Florian221-art/smart_garden/(commit log)

2026-09-28 docs: Projektplan, API-Vertrag und Aufgabenteilung ESP/Webserver
    Claude-Session: https://claude.ai/code/session_01HQDixhkMMb3qe8uDzTaNaT
2026-09-28 docs: Pinout/Verkabelungsplan, Grove-Relais fuer Pumpe, Claude-Regeln in .claude/
    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
2026-09-28 docs: Pinout-Diagramm an echte Board-Belegung angepasst
    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
2026-09-28 docs: KI zu Claude-Web, Pi-Hotspot, Arduino IDE, Tank-Schaetzung (Vertrag v1.1)
    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
2026-09-28 docs: Tech-Stack festgelegt (C++/Arduino, Python/FastAPI, React+Tailwind, lokale KI)
    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
2026-09-28 docs: Demo-Modus (Sensorwerte ueberschreiben), LED-Bar Gruen-Rot, alle Sensordaten im Dashboard (Vertrag v1.2)
    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
2026-09-28 docs: Plaene um Demo-Modus, LED-Bar Gruen-Rot und vollstaendige Sensoranzeige ergaenzt
    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
2026-09-28 tools: fake_esp.py – ESP32-Simulator nach API-Vertrag v1.2
    Simuliert Bodenfeuchte, Licht, Temperatur, Luftfeuchte, Tank-Schaetzung,
    Auto-Bewaesserung mit Sicherheitsgrenzen und wertet commands/config/demo
    aus. Nur Python-Standardbibliothek.
    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
2026-09-28 firmware: ESP32-Firmware v0.1.0 + Verkabelung v2 (kapazitiver Bodensensor)
    - Sensoren: kapazitive Bodenfeuchte (GPIO34), LDR (GPIO35), DHT11 (GPIO4)
    - LED-Bar Rot->Gruen fuer Bodenfeuchte, Summer, Status-LED
    - Auto-Bewaesserung mit harten Sicherheitsgrenzen, Tank-Schaetzung in NVS
    - Demo-Modus (Server + serielle Konsole), Kalibrierung per Konsole
    - POST nach API-Vertrag v1.2, uebernimmt config/commands/demo
    - Kompiliert mit ESP32-Core 3.3.12 ohne Warnungen
    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
2026-09-28 docs: Firmware-Anleitung, Verkabelung v2 (kapazitiver Sensor), Status Claude-ESP
    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
2026-09-28 Phase 1: WLAN-Hotspot-Setup, FastAPI-Grundgerüst, React-Dashboard
    - deploy/: setup_hotspot.sh (NetworkManager-Hotspot "SmartGarden" auf
    wlan0, Pi-IP 10.42.0.1), systemd-Unit, README mit Deployment-Schritten
    - server/: FastAPI + SQLAlchemy/SQLite. POST /api/v1/readings exakt nach
    api-contract.md v1.2 (Pydantic-Validierung, API-Key-Prüfung via argon2,
    Rate-Limit 1req/2s, Antwort mit commands/config/demo). Zusätzlich
    GET /api/v1/devices/{id}/latest fürs Dashboard, GET /healthz und
    CLI zum Anlegen von Geräten samt API-Key.
    - web/: React + Vite + TypeScript + Tailwind v4. Dashboard-Komponente
    pollt /latest alle 5s und zeigt alle aktuellen Sensordaten.
    - Lokal end-to-end getestet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
2026-09-28 docs: Fortschrittsdoku Claude-Web + Fehlertexte im Dashboard
    - docs/server/status.md: ausführliche Doku zu Hotspot/Backend/Dashboard, Testergebnissen und was sich durch den ESP-Firmware-Merge (PR #3, #5) geändert hat (Bodensensor, LED-Bar-Richtung, konkrete Fehlercodes)
    - web/src/errorMessages.ts: übersetzt die in smart_garden.ino definierten Fehlercodes (soil_out_of_range, light_read_failed, dht_read_failed, tank_empty) in verständlichen deutschen Text; unbekannte Codes werden unverändert angezeigt statt zu verschwinden
    - Dashboard zeigt jetzt den übersetzten Text, Rohcode(s) als Hinweis
2026-09-28 Dashboard: Verlaufsdiagramme + Verlaufs-API
    - server: GET /api/v1/devices/{id}/readings (Mittelwerte je Zeit-Bucket,
    Wasser-ml, Auto-Bewässerungen, Demo-Flag, Fehler) und
    GET /api/v1/devices/{id}/config; Zeitstempel jetzt mit Z (UTC)
    - server: app.dev_seed spielt simulierten Verlauf für die Entwicklung ein
    - web: Bereich "Verlauf" mit 1h/24h/7d, Kennzahlen und sechs Diagrammen
    (Bodenfeuchte mit Gießschwelle + Gieß-Markern, Tank, Wasser pro
    Zeitabschnitt, Temperatur, Luftfeuchte, Licht), Demo-Zeiträume markiert,
    Tabellenansicht, hell/dunkel mit geprüfter Palette
    - Status in plan-webserver.md und docs/server/status.md
    Cla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
2026-09-28 server: pydantic auf 2.13.5 für Python 3.14
    pydantic 2.9.2 (pydantic-core 2.23.4) hat keine fertigen Pakete für
    Python 3.14 und lässt sich dort nicht bauen (PyO3 0.22 unterstützt max.
    3.13) - pip install scheiterte auf dem Mac. 2.13.5 hat Wheels für macOS
    arm64 (Py3.14) und den Pi (aarch64, Py3.11/3.13); FastAPI 0.115 ist
    kompatibel. POST/401/422, /latest und /readings erneut getestet.
    Claude-Session: https://claude.ai/code/session_01PSo26csWhAiuDusFTWjDVb
2026-09-28 Fix: eigener LED-Bar-Treiber statt Grove-Library (#9)
    Die Library im Arduino-Bibliotheksverwalter ist eine aeltere Version ohne
    LED_BAR_10 -> Kompilierfehler. Eigener Treiber (ledbar.cpp), eine
    Bibliothek weniger zu installieren.
    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
    [display.cpp, ledbar.cpp, ledbar.h]
2026-09-28 server: SQLAlchemy auf 2.0.54 für Python 3.14
    SQLAlchemy 2.0.35 bricht unter Python 3.14 beim Import der Modelle ab
    (TypeError in make_union_type). Mit echtem Python 3.14 getestet:
    Seed, POST 200/401/422/429, /latest, /readings, /config, /openapi.json.
    Fertige Pakete für macOS arm64 (3.14) und Pi (aarch64, 3.11/3.13).
    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
2026-09-28 Demo-Modus (Server): Demo- und Befehls-Endpunkte
    - GET/PUT/DELETE /api/v1/devices/{id}/demo (Overrides + erzwungene Fehler,
    geprüft gegen Vertrag, 10-600 s, läuft serverseitig ab)
    - POST /readings liefert `demo` jetzt an den ESP (expires_in_s = Restzeit)
    - GET/POST /api/v1/devices/{id}/commands (gießen begrenzt auf
    max_pump_s_per_run, Tank aufgefüllt, identify, Summer; genau einmal)
    - Noch ohne Login: jeder im Hotspot kann die Demo auslösen (dokumentiert)
    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
2026-09-28 Demo-Modus (Dashboard): Szenario-Buttons, eigene Werte, Gerätebefehle
    - Demo-Steuerung mit 5 Szenarien, Schiebereglern, Sensorausfall,
    Dauer + Countdown, Bestätigung durch das Gerät, Gerätebefehle
    - DEMO-Banner für alle und DEMO-Badge an betroffenen Kacheln
    - Steuerung ein-/ausblendbar (Beamer-Ansicht)
    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
2026-09-28 Dashboard fürs Handy: WLAN-Zugriff, Web-App und Handy-Layout
    - web: `npm run dev:mobil` (vite --host) macht das Dashboard im WLAN
    erreichbar; /api läuft weiter über den Proxy auf dem Rechner
    - server: liefert web/dist unter / aus, falls gebaut - auf dem Pi reicht
    ein Dienst, Handy im Hotspot öffnet http://10.42.0.1:8000
    - Web-App-Manifest, eigenes Icon (Keimling mit Wassertropfen),
    theme-color, viewport-fit=cover -> "Zum Home-Bildschirm"
    - Handy-Layout: Kacheln und Szenarien zweispaltig, Touch-Ziele >= 44 px,
    safe-area für Notch/Home-Leiste, kein Fokusrahmen nach Antippen von
    Diagrammen, Demo-Zeitraum in der Legende statt abgeschnittenem Label
    - Geprüft per iPhone-13-Emulatio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
2026-09-28 Firmware v0.2.0 (#14)
    * firmware v0.2.0: Einstellungen ganz oben, LED-Zeiger, ruhigerer Summer, klare Pumpen-Sperrmeldung
    - Einstellungsblock (WLAN, Server, LED-Bar, Summer) in den ersten Zeilen von smart_garden.ino
    - LED-Bar: neuer Standard "Zeiger" (trocken = rot, feucht = gruen), Fuellbalken optional,
    CFG_LEDBAR_REVERSE zum Spiegeln, Testbefehl "ledseg"
    - Summer: piept nur bei neuem Problem, sonst max. alle 10 min; Grund als [ALARM] im Log; "mute"
    - Pumpe: Meldung, wenn Auto-Giessen wegen leerem Tank/Tageslimit gesperrt ist; Hinweis beim Start
    * docs: Firmwa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
    [display.cpp, display.h, garden_config.cpp, garden_config.h, smart_garden.ino]
2026-09-28 Firmware v0.2.1 (#15)
    * firmware v0.2.1: DHT11 stabil, kein Dauerpiepen, Demo giesst sofort
    - DHT11 nur alle 5 s lesen, letzten guten Wert 30 s halten (vorher: Lesen alle 2 s + erzwungener Retry -> Fehler)
    - Alarm: Sensorfehler erst nach 60 s, Problem gilt erst nach 5 min Ruhe als erledigt (kein Piepen bei Wackelkontakt)
    - "demo soil <x>" unter Grenzwert giesst sofort einmal, ohne die 5-min-Pause
    - Log-Meldung, wenn Giessen wegen Pause (Cooldown) wartet
    - LED-Test beim Start langsamer mit Hinweis
    * firmware v0.2.1: Demo-Kick, Alarm-Hysterese, LED-Test
    Co-Authore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
    [demo.cpp, demo.h, display.cpp, garden_config.h, pump.cpp, pump.h, sensors.cpp, smart_garden.ino]
2026-09-28 Firmware v0.2.2: LED-Bar Pins tauschbar (#16)
    * firmware v0.2.2: LED-Bar Daten-/Taktpin tauschbar (ledswap, CFG_LEDBAR_SWAP_PINS)
    * firmware v0.2.2: Einstellung + Konsolenbefehl ledswap
    ---------
    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
2026-09-28 Firmware v0.2.3: LED-Bar-Pins korrigiert (#17)
    Im Hardwaretest hat die LED-Bar erst nach "ledswap" reagiert. Pinbelegung
    jetzt fest so eingestellt, Verkabelungsplan angepasst (Kabel bleiben wie sie sind).
    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
    [garden_config.h]
2026-09-28 firmware v0.2.4: LED-Bar Trockenheitsbalken ab Grün (Standard)
    Je trockener die Erde, desto mehr LEDs: erst die grünen, dann orange,
    ganz trocken auch rot. ledtest füllt jetzt von Grün nach Rot.
    status zeigt zusätzlich swap=.
    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
    [display.cpp, garden_config.cpp, garden_config.h]
2026-09-29 Firmware v0.3.0: Sicherheits-Review, vollständige Kommentare und Doku (#20)
    * firmware v0.3.0 (1/4): Config, Tank, Pumpe-Header, Sensoren, LED-Treiber, Doku-Kommentare
    * firmware v0.3.0 (2/4): Pumpe, Netz, Demo, Anzeige
    * firmware v0.3.0 (3/4): Sketch (Gieß-Plausibilität, Watchdog), secrets.h-Vorlage, README
    Claude-Session: https://claude.ai/code/session_01HQDixhkMMb3qe8uDzTaNa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
2026-09-29 Firmware v0.3.1: LED-Bar-Fix, LED-Tabelle nach Florian, Intervall 10 s (#22)
    * firmware v0.3.1: LED-Bar-Latch wie Seeed (keine Extra-Taktflanken), Anzeige jede Sekunde auffrischen, Intervall 10 s
    * firmware v0.3.1: LED-Tabelle nach Florian (100 % = 1 grün ... 30 % = 8 grün, 20 % + orange, ≤10 % + rot), Intervall 10 s, Doku
    * docs: Firmware-README auf 0.3.1 (LED-Tabelle, Intervall 10 s)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
    [display.cpp, display.h, garden_config.h, ledbar.cpp]
2026-09-29 firmware v0.3.2: LED-Bar mit 25 % Helligkeit, saubere Flanken, Test endet nicht auf "alle an"
    Alle 10 LEDs mit voller Helligkeit ließen die Anzeige auf "alle an" hängen.
    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
2026-09-29 firmware v0.3.2: LED-Test endet ohne "alle an", Version
    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
2026-09-29 LED-Bar: Helligkeit 25 %, saubere Flanken, Test endet nicht auf „alle an“ (#23)
    * firmware v0.3.2: LED-Bar mit 25 % Helligkeit, saubere Flanken, Test endet nicht auf "alle an"
    * firmware v0.3.2: LED-Test endet ohne "alle an", Version
    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
2026-09-29 Firmware v0.3.3: LED-Bar-Pins korrigiert (gelb = DI, weiß = DCKI) (#25)
    * firmware v0.3.3: LED-Bar-Pins korrigiert (gelb = DI D18, weiß = DCKI D19), Seeed-Latch wiederhergestellt
    Platinenaufdruck DI/DCKI/VCC/GND bestätigt: gelb = DI, weiß = DCKI.
    v0.2.3 hatte die Pins fälschlich getauscht -> Flackern/alle an.
    * docs: Verkabelung LED-Bar korrigiert (gelb = DI D18, weiß = DCKI D19)
    ---------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
    [garden_config.h, ledbar.cpp]
2026-09-29 Firmware v0.3.4: Versionsnummer ganz oben im Sketch (#26)
    * firmware v0.3.4: Versionsnummer ganz oben im Sketch
    * firmware v0.3.4: FW_VERSION + Regel im Plan (Version immer oben eintragen)
    * plan-esp: Versionsregel, Versionsliste bis 0.3.4, LED-Pins korrigiert
    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
    [garden_config.h, smart_garden.ino]
2026-09-29 Firmware v0.3.5: LED-Diagnose (leddiag) + Treiber wie Original-Stand (#27)
    * firmware v0.3.5 (1/2): LED-Treiber mit einstellbaren Varianten (Helligkeit, Tempo, Latch)
    * firmware v0.3.5 (2/2): leddiag-Befehl, LED-Optionen oben im Sketch, Version 0.3.5
    * firmware v0.3.5: Sketch (Version, LED-Optionen, leddiag)
    Claude-Session: https://claude.ai/code/session_01HQDixhkMMb3qe8uDzTaNaT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
2026-09-29 Deployment auf den Raspberry Pi mit einem Befehl
    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
2026-09-29 Firmware v0.3.7: WLAN ereignisgesteuert, verständliche Fehlermeldungen (#29)
    * Firmware 0.3.7: WLAN ereignisgesteuert, Trenngrund im Klartext, WLAN aus bei Platzhalter-Passwort
    * Doku 0.3.7: WLAN-Meldungen, leddiag, Plan-ESP
    * Sketch-Kopf: FIRMWARE-VERSION 0.3.7
2026-09-29 Firmware v0.3.8: Pumpenstoß 0,5 s (Auto, Demo, Dashboard) (#31)
    * Firmware 0.3.8: Pumpenstoß 0,5 s (Auto, Demo, Dashboard), Settings-Version, serielles pump bis 15 s
    * Firmware 0.3.8: Pumpenstoß 0,5 s (Auto, Demo, Dashboard), Settings-Version, serielles pump bis 15 s
    * Firmware 0.3.8: Pumpenstoß 0,5 s (Auto, Demo, Dashboard), Settings-Version, serielles pump bis 15 s
2026-09-29 Firmware 0.3.9: kleiner Spritzer – Stoß hart 0,3–1 s, Demo fest 0,5 s
2026-09-29 Firmware 0.3.9: kleiner Spritzer – Stoß hart 0,3–1 s, Demo fest 0,5 s (#37)
2026-10-01 Demo ohne Hardware: deploy/demo.sh, .demo/ ignorieren
    - deploy/demo.sh baut das Dashboard, legt eine Wegwerf-Demo-DB mit 48 h
    Testdaten an, startet Server und fake_esp.py und öffnet das Dashboard
    - .gitignore: .demo/
    Claude-Session: https://claude.ai/code/session_0154WiEqsrxZsrnTwkfgCFnV
